windbird-sensor/windbird-fox-electronics/Parts.ods

Windbird Electronic Component List and References
Design Ref | Descr | Mfr | Mfr Part Nbr | OWM Stock | OWM Ordered | New? | # | Supplier Price (x100) | Supplier Stock (Dec21) | Supplier Ref | Supplier Link
U0 | Micro+Radio | Telecom Design | TD1208r | 500 |  | No | 1
U3 | GPS | Quectel | L80-M39 | 263 |  | No | 0 | 840 | 0 | 277-L80-M39 | https://www.mouser.fr/ProductDetail/Quectel/L80-M39?qs=GedFDFLaBXEPqYfo45AE6g%3D%3D
 |  |  | L80RE-M37 |  | 237 |  | 1 | 660 | 0 | 277-L80RE-M37 | https://www.mouser.fr/ProductDetail/Quectel/L80RE-M37?qs=sGAEpiMZZMu3sxpa5v1qrlnBiwhQeiBhi9WeJRp64R0%3D
D2 | LED | Lite-On | W115WSURKMGKW | 0 | 500 | Yes | 0 | 46.5 | 164 | 604-W115WSURKMGKW | https://www.mouser.fr/ProductDetail/604-W115WSURKMGKW
SW1 | Tact switch | TE conn | 1571300-2 | 0 |  | No | 0 | 53.9 | thousands | 571-15713002 | https://www.mouser.fr/ProductDetail/TE-Connectivity/1571300-2?qs=bkeGI61iuy0uEFNu3cmI%252BA%3D%3D
 |  |  |  |  | 500 |  | 1 | 48 | thousands | 450-2127-ND | https://www.digikey.fr/fr/products/detail/te-connectivity-alcoswitch-switches/1571300-2/2400327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
D1 | TVS | OnSemi | ESD9R3.3ST5G | 0 |  | No | 1 | 35.9 | thousands | 863-ESD9R3.3ST5G | https://www.mouser.fr/ProductDetail/onsemi/ESD9R33ST5G?qs=N5dOQkml4H9504itvxWhoA%3D%3D
 |  |  |  |  | 500 |  | 0 | 36.4 | thousands | SD9R3.3ST5G | https://www.digikey.fr/fr/products/detail/onsemi/ESD9R3-3ST5G/1961067
U2 | Compass | ST | LSM303AGRTR | ? |  | Yes | 0 | 395 | 0 | 511-LSM303AGRTR | https://www.mouser.fr/ProductDetail/STMicroelectronics/LSM303AGRTR?qs=dTJS0cRn7oj2TlQhcroMCw%3D%3D
 |  | MEMSIC | MC6470 | 0 | 1000 | Yes | 1 | 134 | 0 | 498-MC6470 | https://www.mouser.fr/ProductDetail/MEMSIC/MC6470?qs=u6%2FIMcj1sDuOjN54xX4NKQ%3D%3D
 | Magnetic Sensor | MDT | TMR1202S | 500 |  | Yes | 0 | 149 | 49 | 2895401 | https://fr.farnell.com/multi-dimension/tmr1202s/sensor-bipolar-switch-5-5v-sot/dp/2895401
 |  |  |  |  |  |  | 1 | 81.2 | 75 | 3542-TMR1202S-ND | https://www.digikey.com/en/products/detail/multidimension/TMR1202S/14301741
C1 | SuperCap | Cornell | DGH105Q5R5 | 0 |  | Yes | 1 | 172 | thousands | 598-DGH105Q5R5 | https://www.mouser.fr/ProductDetail/Cornell-Dubilier-CDE/DGH105Q5R5?qs=5aG0NVq1C4zTI3AbZR5TsA%3D%3D
U1 | DCDC conv | TI | TPS82740ASIPR | 0 |  | yes | 1 | 179 | thousands | 595-TPS82740ASIPR | https://www.mouser.fr/ProductDetail/Texas-Instruments/TPS82740ASIPR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
SI1 | Load Switch | Vishay | SI1865DDL-T1-GE3 | ? |  | No | 1 | 18.7 | thousands | 78-SI1865DDL-T1-GE3 | https://www.mouser.fr/ProductDetail/Vishay-Semiconductors/SI1865DDL-T1-GE3?qs=XynAqUfUlD06GSEfn4KgAA%3D%3D
J_RF | Coax ufl conn | Linx | CONUFL001-SMD-T | ? |  | No | 1 | 50.8 | thousands | 712-CONUFL001-SMD-T | https://www.mouser.fr/ProductDetail/Linx-Technologies/CONUFL001-SMD-T?qs=EU6FO9ffTwfRdkBeQTdJWQ%3D%3D
J_BAT | Batt Conn |  | JST-PH |  |  |  | 0 |  | 0 | 485-1769 | https://www.mouser.fr/ProductDetail/Adafruit/1769
 |  | JST | B2B-PH-SM4-TB | 0 |  | yes | 1 | 32 | 0 | 455-1734-2-ND | https://www.digikey.fr/en/products/detail/jst-sales-america-inc./B2B-PH-SM4-TBLFSN/926641 https://www.jst.fr/core/file.get?path=doc/jst/family/pdf/ePH.pdf
Q3, Q5, Q6 | Mosfet N |  | PMV30UN2R |  |  | yes | 3 | 20.2 | thousands |  | https://www.digikey.fr/fr/products/detail/nexperia-usa-inc/PMV30UN2R/5395795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
 |  |  |  |  |  |  | 0
Q1, Q2, Q4 | Mosfet P |  | SI2301-TP |  |  | yes | 3 | 18.2 | thousands |  | https://www.digikey.fr/fr/products/detail/micro-commercial-co/SI2333-TP/6616110
 |  |  | SI2301CDS-T1-GE3 |  |  |  | 0 |  | thousands |  | https://fr.farnell.com/vishay/si2301cds-t1-ge3/mosfet-canal-p-20v-3-1a-sot23/dp/1779260RL
R8,R9, R10,R13 | R10k |  |  |  |  |  | 4
R5, R18 | R2.7M, 1% |  |  |  |  |  | 2
R4,R11,R12, R14,R17 | R1M, 1% |  |  |  |  |  | 5
R1 | R120 |  |  |  |  |  | 1
R3 | R10 |  |  |  |  |  | 1
R15,R16 | R100k |  |  |  |  |  | 2
R7 | R22 1/10W | Vishay | CRCW060322R0FKTA | 0 | 0 | yes | 1 | 4.5 | 900 | 71-CRCW0603-22 | https://www.mouser.fr/c/passive-components/resistors/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
C3,C6 | C10u |  |  |  |  |  | 2
C2,C4,C5,C7 | C100n |  |  |  |  |  | 4
 | Flex cable | TE conn | A9AAT-0304F | 0 | 500 | yes | 1 | 52 | 417 | A9AAT-0304F-ND | https://www.digikey.com/en/products/detail/te-connectivity-amp-connectors/A9AAT-0304F/137607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
PRICE |  |  |  |  |  |  |  | 1583.3
BACKUP:
Mosfet NP pack | Wishay | SIA517DJ-T1-GE3 | 0 | 30 | yes | 3 | 52.3 | 715 ! | 781-SIA517DJ-GE3 | https://www.mouser.fr/ProductDetail/Vishay-Semiconductors/SIA517DJ-T1-GE3
 |  |  |  |  |  |  | 44.1 | 800 | 2889717RL | https://fr.farnell.com/vishay/sia517dj-t1-ge3/mosfet-canal-n-p-12v-4-5a-powerpak/dp/2889717RL?mckv=s_dc|pcrid|522450084451|kword|sia517dj%20t1%20ge3|match|p|plid||slid||product||pgrid|124102818202|ptaid|kwd-382153597170|&CMP=KNC-GFR-GEN-SKU-MDC-Semiconductors-TargetImprShare-10-Jan-22
LDO1 | LDO |  | NCP4681DSQ33T1G |  |  |  | 0 |  | obsolete
 |  | Ricoh | R1180N331C-TR-FE | 0 |  | Yes | 0 | 42.3 | thousands | 848-R1180N331CTRFE | https://www.mouser.fr/ProductDetail/Ricoh-Electronics/R1180N331C-TR-FE?qs=ilL34mSzaLjMJxGTa%2Fjc3Q%3D%3D
 | Slide Switch | CUI | MSS-102568-14A-90-D | optional |  |  | 0 | 64.6 | 400 | 490-MSS102568-14A90D | https://eu.mouser.com/ProductDetail/CUI-Devices/MSS-102568-14A-90-D?qs=DRkmTr78QAQmVOwkdz%2F1Dg%3D%3D
 | SuperCap | Tecate | TPLH-2R7/ 1.5WR6X15 | 0 |  | Yes | 0 | 93.97 | 550 | 2085-TPLH-2R7/1.5WR6X15-ND | https://www.digikey.fr/en/products/detail/tecate-group/TPLH-2R7-1-5WR6X15/9930255
 | DCDC conv | TI | TPS82740B | 0 |  | Yes | 0 | 170 | thousands | 595-TPS82740BSIPR | https://www.mouser.fr/ProductDetail/Texas-Instruments/TPS82740BSIPR?qs=1MXlzafEN3%2FI4PvBcL5k9g%3D%3D
 | Cable+JSTPH |  |  |  |  |  |  |  |  |  | https://www.amazon.fr/Pi%C3%A8ces-2-Broches-Connecteur-Silicone-Femelle/dp/B07449V33P
