windbird-sensor/windbird-fox-electronics/main/main.pdf

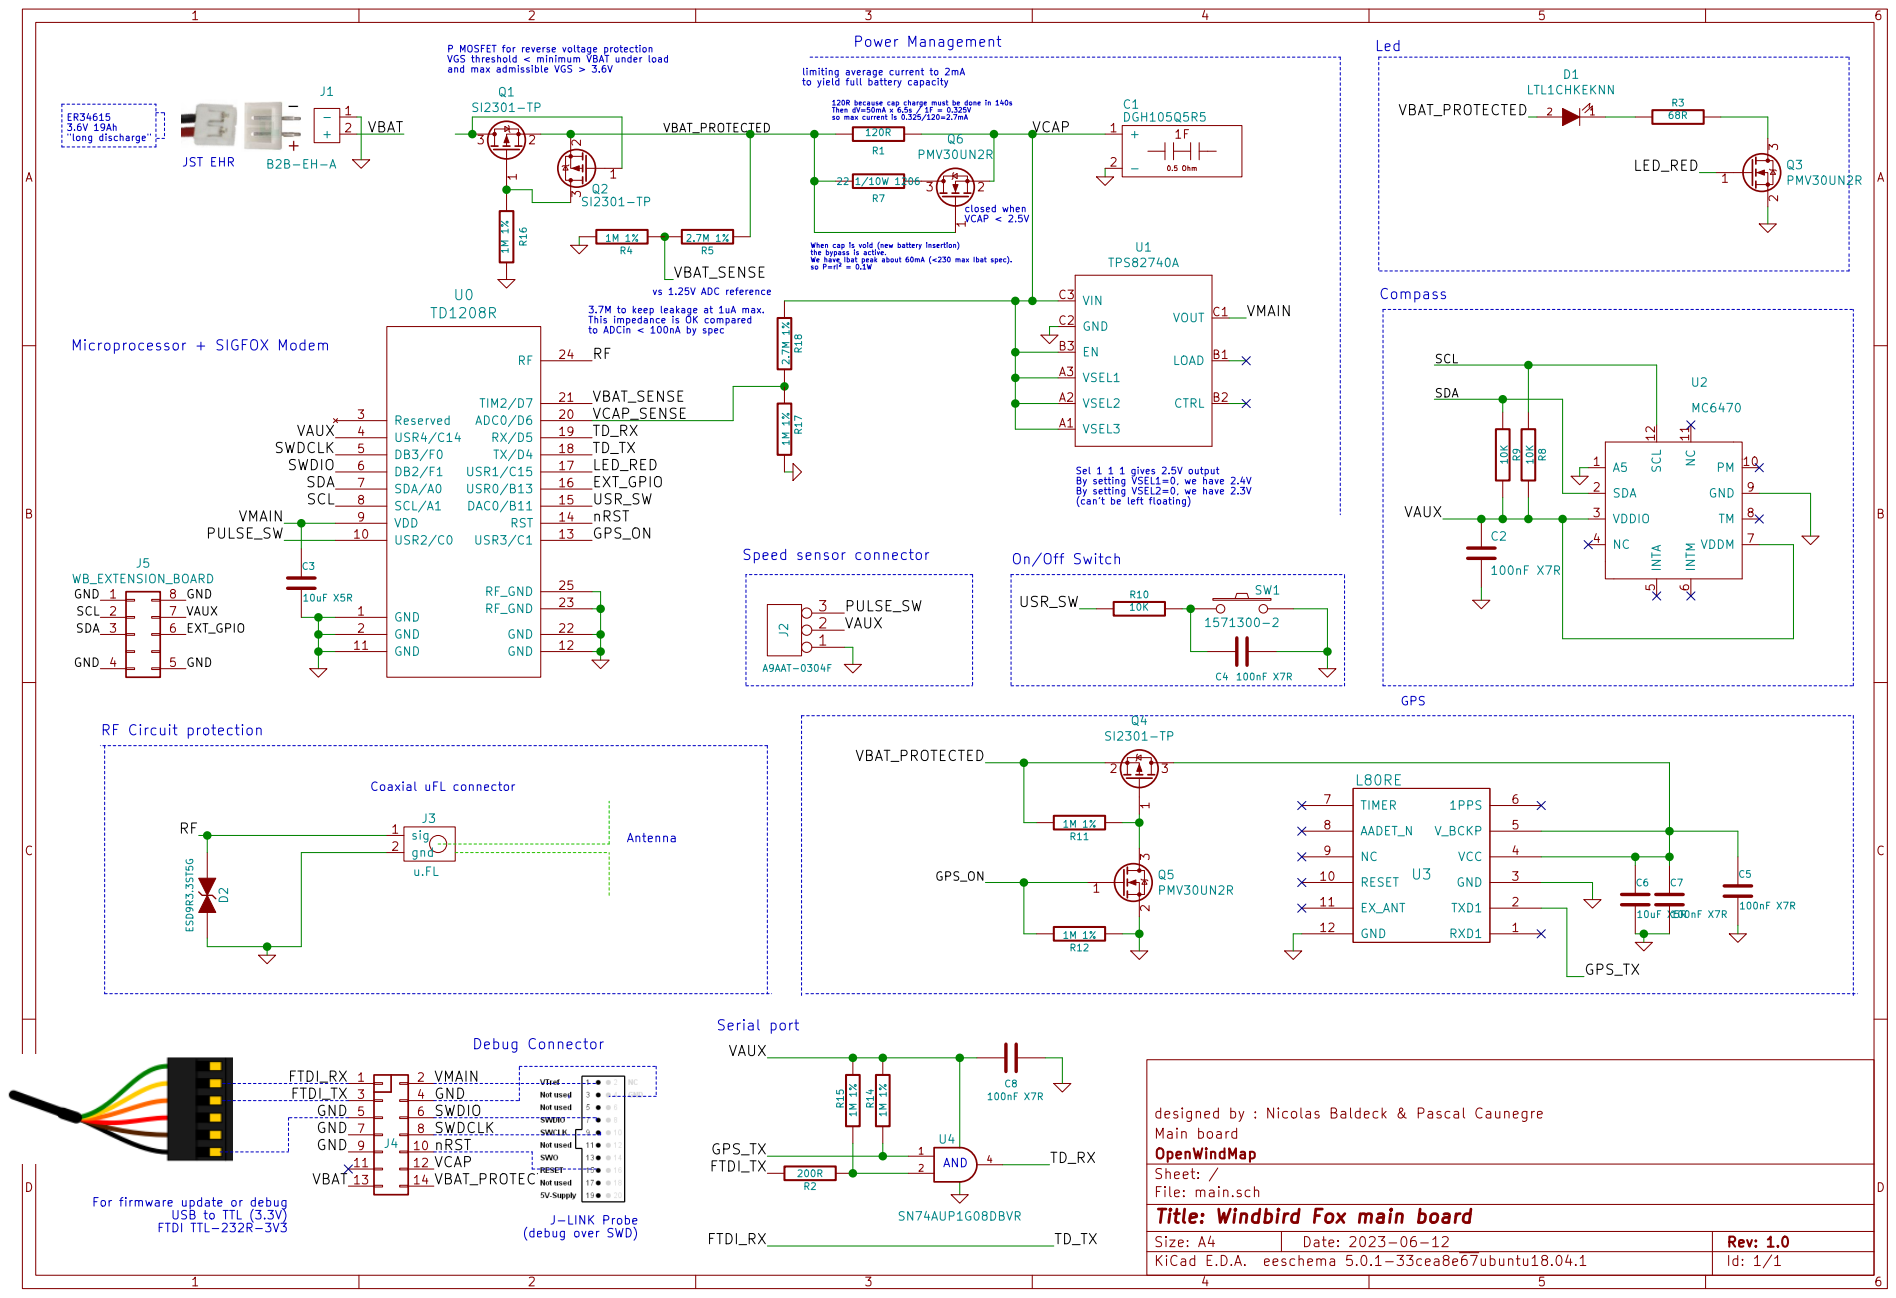
[picture p12: page 1]

P MOSFET for reverse voltage protection VGS threshold < minimum VBAT under load

120R Power Management 3.7M to keep leakage at 1uA max. This impedance is OK compared

to yield full battery capacity R5

120R because cap charge must be done in 140s Then dV=50mA x 6.5s / 1F = 0.325V

so max current is 0.325/120=2.7mA LED_RED

the bypass is active. We have Ibat peak about 60mA (<230 max Ibat spec). so P=rI² = 0.1W R18 2.7M 1% R17 1M 1%VCAP_SENSE

When cap is void (new battery insertion)

to ADCin < 100nA by spec

6 VDDM 7 TM 8 GND 9 U2MC6470 SCL SDA C2

Sel 1 1 1 gives 2.5V output By setting VSEL1=0, we have 2.4V
By setting VSEL2=0, we have 2.3V

(can't be left floating) PULSE_SW

designed by : Nicolas Baldeck & Pascal Caunegre
File: main.sch Sheet: / OpenWindMap Main board

Id: 1/1 Title: Windbird Fox main board

For firmware update or debug
