windbird-sensor/windbird-fox-electronics/(commit log)

2021-12-20 legacy schematic
    [main.sch]
2021-12-20 added front and tail boards legacy
    [front.kicad_pcb, front.sch, main.sch, tail.kicad_pcb]
2021-12-23 new compass integrated
    [Parts.ods, main.sch]
2021-12-23 Changed Power Supply management
    [Parts.ods, main.sch]
2021-12-23 move libraries to dedicated folder
    [main.sch]
2021-12-23 fix unconnected node
    [main.sch]
2021-12-23 updated gps to add L80RE
    [Parts.ods, main.sch]
2021-12-23 remove pioupiou logo
    [tail.kicad_pcb]
2021-12-23 fix unconnected pins
    [main.sch]
2021-12-24 added design note about power mngt
2021-12-26 chged gps connection, buck ref, etc
    [Parts.ods, main.sch]
2021-12-26 replace TPS82740B by TPS82740A (different voltage range)
    [main.sch]
2021-12-26 add missing node on VBAT testpoint
    [main.sch]
2021-12-26 fix labels
    [main.sch]
2021-12-26 VSEL pins can not be left floating. Adding solder jumpers
    [main.sch]
2021-12-26 auto update pdf schematics from commit 3248a544d6a922d13c931a219bf489f47ed66609
2021-12-26 add kicad libraries
2021-12-27 execute only on schematic uptdate
2021-12-27 auto update pdf schematics from commit e076a5db34ef77dc8e55f9870a2acf786f4a9f9a
2021-12-27 update battery and power management
    [main.sch]
2021-12-27 auto update pdf schematics from commit cc0e7e08a8ab413ad164c1ca6ffb7bc0cd787cc9
2021-12-27 update gitignore to exclude schematics pdfs
2021-12-27 work in progress
    [main.sch]
2021-12-27 auto update pdf schematics from commit 2817c4c66c8fd654028d224dca44f309051f5db7
2021-12-27 update ordered parts
    [Parts.ods]
2021-12-28 minor component list update
    [Parts.ods]
2021-12-29 revert back on uart+minor changes and doc
    [main.sch]
2021-12-29 auto update pdf schematics from commit e2a9079ac370ef43f319a19618beb192cca6a7e0
2021-12-29 add quick charge mosfet
    [main.sch]
2021-12-29 dual color led
    [main.sch]
2021-12-29 implement UART port level shifting and priority
    [main.sch]
2021-12-29 auto update pdf schematics from commit 39f76c75e53f4eca96dea86b57aac22b1a101a14
2021-12-30 replace GPS load switch by 2 mosfets
    [main.sch]
2021-12-30 group n and p mos in a single package
    [main.sch]
2021-12-30 add pull-down to GPS switch
    [main.sch]
2021-12-30 set default regulator voltage to 2.3V
    [main.sch]
2021-12-30 auto update pdf schematics from commit a5ba8916dd4fb00dad472c0323115549850d945f
2021-12-30 add testpoints for VBAT and VCAP
    [main.sch]
2021-12-30 reset parts numbering
    [main.sch]
2021-12-30 assign footprints
    [main.sch]
2021-12-30 add template pcb
    [windbird_main_template.kicad_pcb]
2021-12-30 auto update pdf schematics from commit 1bfbf1b4490ed8f5c74971a1fccdfa52bca92992
2021-12-30 fix windbird_main_template.kicad_pcb
    [windbird_main_template.kicad_pcb]
2021-12-30 Create pcb and load netlist / footprints. No routing yet.
    [main.kicad_pcb]
2021-12-30 first draft of components placement
    [main.kicad_pcb, main.sch, windbird_main_template.kicad_pcb]
2021-12-30 auto update pdf schematics from commit a46d02682a682c8f71ca3364ed2df54fdbb58fc7
2021-12-30 fix jlink connector
    [main.sch]
2021-12-30 auto update pdf schematics from commit d3190f0d5ee5508cfd40afc682392847a8319fe9
2021-12-30 fix j-link when generating pdf
    [main.sch]
2021-12-30 auto update pdf schematics from commit d57144c3445cfde162382bc8ae85589db36a9986
2021-12-31 first routing attempt
    [main.kicad_pcb, main.sch]
2021-12-31 auto update pdf schematics from commit 8d99d146532c3bb13df4d1d5b70e14e86439053b
2022-01-03 fixed P/N mosfets
    [main.sch]
2022-01-03 auto update pdf schematics from commit 86e8e0c8c96b83c96f0b173e7fd4ac15da8e61ed
2022-01-09 added mosfets, measure of vcap
    [Parts.ods, main.sch]
2022-01-09 auto update pdf schematics from commit 8c155c7b05a3d65915cdd65e21dea0ea2715191e
2022-01-10 added SIA217 comp
    [main.sch]
2022-01-10 updated PCB with mosfet, reviewed track size, added marks
    [main.kicad_pcb, main.sch]
2022-01-10 auto update pdf schematics from commit cee8e55374db86100fc12d35e086ad1d40817ea0
2022-01-27 added supplier for the Mos device
    [Parts.ods]
2022-01-27 corrected typos on board marks
    [main.kicad_pcb]
2022-01-28 added passive components in parts list
    [Parts.ods]
2022-02-05 update components values
    [main.sch]
2022-02-05 reverse JST connector polarity
    [main.sch]
2022-02-05 power gps from VBAT_PROTECTED
    [main.sch]
2022-02-05 remove vmain testpoint (already on pin header)
    [main.sch]
2022-02-09 new design attempt for serial port level shifter / multiplexer
    [main.sch]
2022-02-09 auto update pdf schematics from commit 3ed0fd3160f9d40e0d6892d48b827e23bf5fbce3
2022-02-09 power accessories on switchable VAUX
    [main.sch]
2022-02-09 swap pins on TD1208R (ADC is only available on D4/D5/D6/D7)
    [main.sch]
2022-02-09 auto update pdf schematics from commit 73cf3e01b970db14bbd31492f0c8f13248573370
2022-02-16 Changed reverse voltage protection
    [main.sch]
2022-02-16 added nmos to control led
    [main.sch]
2022-02-16 Parts file updated
    [Parts.ods]
2022-02-16 auto update pdf schematics from commit d4b7c6b8d160b24ba7c85b82a3e108355f60b6ba
2022-02-28 changed R7 (bypass) for 22R
    [Parts.ods, main.sch]
2022-02-28 auto update pdf schematics from commit ce712707fa77fadc9db673f947a466c3173eaf08
2022-04-12 proto rev 0.2
    [main.kicad_pcb, main.sch]
2022-04-12 auto update pdf schematics from commit 12b182eec39ad9fa74d185f90f5f06fc7dcb52b3
2022-04-12 add missing gnd vias
    [main.kicad_pcb]
2022-04-13 cleared one DRC failure about Vmain/gnd short risk
    [main.kicad_pcb]
2022-04-13 added 2 mosfet refs in parts list
    [Parts.ods]
2022-04-26 fixing pcb and replacing led footprint
    [main.kicad_pcb]
2022-04-26 fix silkscreen
    [main.kicad_pcb]
2022-04-26 update led footprint
    [main.sch]
2022-04-26 gerber for prototype rev 0.2
    [main-1_F_Cu.gtl, main-4_B_Cu.gbl, main-B_Mask.gbs, main-B_SilkS.gbo, main-Edge_Cuts.gm1, main-F_Mask.gts, main-F_Paste.gtp, main-F_SilkS.gto]
2022-04-26 auto update pdf schematics from commit 83bbe50ec4add28125468af81fddf7af80644279
2023-01-25 update front board
    [front.kicad_pcb]
2023-01-25 removal of a unnecessary via
    [main.kicad_pcb]
2023-01-25 move the RF connector and the ESD diode
    [main.kicad_pcb]
2023-01-25 indicate led polarity
    [main.kicad_pcb]
2023-01-25 samll routing fixes
    [main.kicad_pcb]
2023-01-25 slightly move the main connector
    [main.kicad_pcb]
2023-01-25 add outline to memsic footprint
    [main.kicad_pcb]
2023-01-25 add Q_PMOS_GSD and Q_NMOS_GSD to _WINBIRD symbols library
    [main.sch]
2023-01-25 auto update pdf schematics from commit 4d77068c8b204a390017d90e112ed926f5fd1bf3
2023-05-01 correction nom symbole jst
    [main.kicad_pcb, main.sch]
2023-05-01 add 3d models
    [front.kicad_pcb]
2023-05-01 cleanup reference labels
    [main.kicad_pcb]
2023-05-01 fix pinout table
    [main.kicad_pcb]
2023-05-01 replace battery connector for JST EHR
    [main.kicad_pcb, main.sch]
2023-05-01 fix serial multiplexer
    [main.kicad_pcb, main.sch]
2023-05-01 move td1208's capacitor
    [main.kicad_pcb, main.sch]
2023-05-01 add courtyard to switch footprint
    [main.kicad_pcb]
2023-05-01 remove useless resistor
    [main.kicad_pcb, main.sch]
2023-05-01 make more room around the led and button, to facilitate board coating
    [main.kicad_pcb, main.sch]
2023-05-01 move rx and tx lines to inner layer
    [main.kicad_pcb]
2023-05-01 add footprint for extension board
    [main.kicad_pcb, main.sch]
2023-05-01 auto update pdf schematics from commit 41697f6bb1d7fc54bbd043d59b770514fad6239e
2023-05-02 add polyfuse to comply with fire safety requirements
    [main.kicad_pcb, main.sch]
2023-05-02 rev 1.0-rc2
    [main-1_F_Cu.gtl, main-4_B_Cu.gbl, main-B_Mask.gbs, main-B_Paste.gbp, main-B_SilkS.gbo, main-Dwgs_User.gbr, main-Edge_Cuts.gm1, main-F_Mask.gts]
2023-05-02 auto update pdf schematics from commit d714799b96dc32cbde7ab322941e93da73798db4
2023-06-12 update footprint for connection to wind sensor
    [main.kicad_pcb]
2023-06-12 v1.0 release
    [main-1_F_Cu.gtl, main-4_B_Cu.gbl, main-B_Mask.gbs, main-B_Paste.gbp, main-B_SilkS.gbo, main-Dwgs_User.gbr, main-Edge_Cuts.gm1, main-F_Mask.gts]
2023-06-12 auto update pdf schematics from commit 3552f8894cabf5626d916dba02bfdd60e2beab9c
2023-08-04 v1.0.1 - ready for production
    [main.kicad_pcb, main.sch]
2023-08-04 add frontboard to main pcb file
    [main.kicad_pcb]
2023-08-04 tune antenna for weigth and resonance frequency
    [tail.kicad_pcb]
2023-08-04 fix broken contour
    [tail.kicad_pcb]
2023-08-04 New artwork, with the help of designers from nodesign.net
    [tail.kicad_pcb]
2023-08-04 auto update pdf schematics from commit afd66acbfb1d48973a90da6b8e518a22f84a6a49
